theapi/kitchen_timer_stm32/docs/hero2.jpg

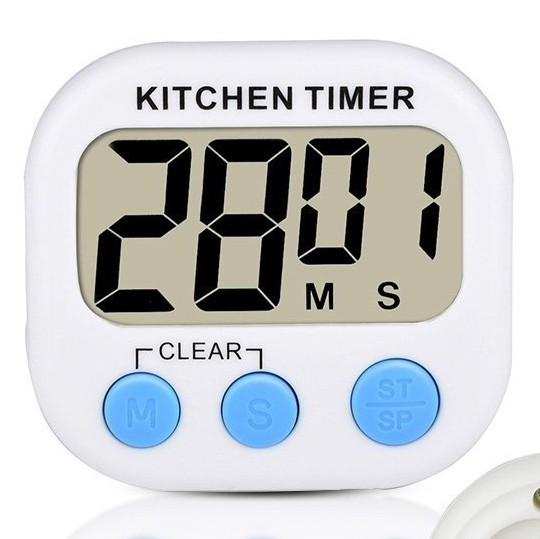
docs/hero2.jpg
