theapi/kitchen_timer_stm32/README.md

# kitchen_timer_stm32
A kitchen timer using the Arm STM32
