theapi/kitchen_timer_stm32/docs/hero.jpg

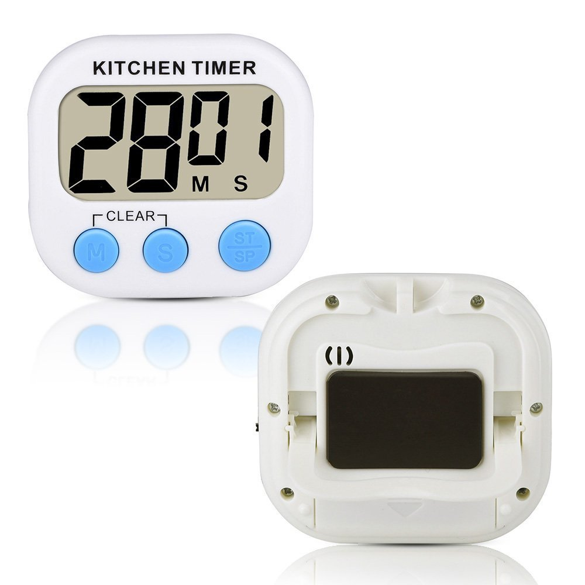
docs/hero.jpg
