theapi/kitchen_timer_stm32/kicad/stm32l053c.pdf

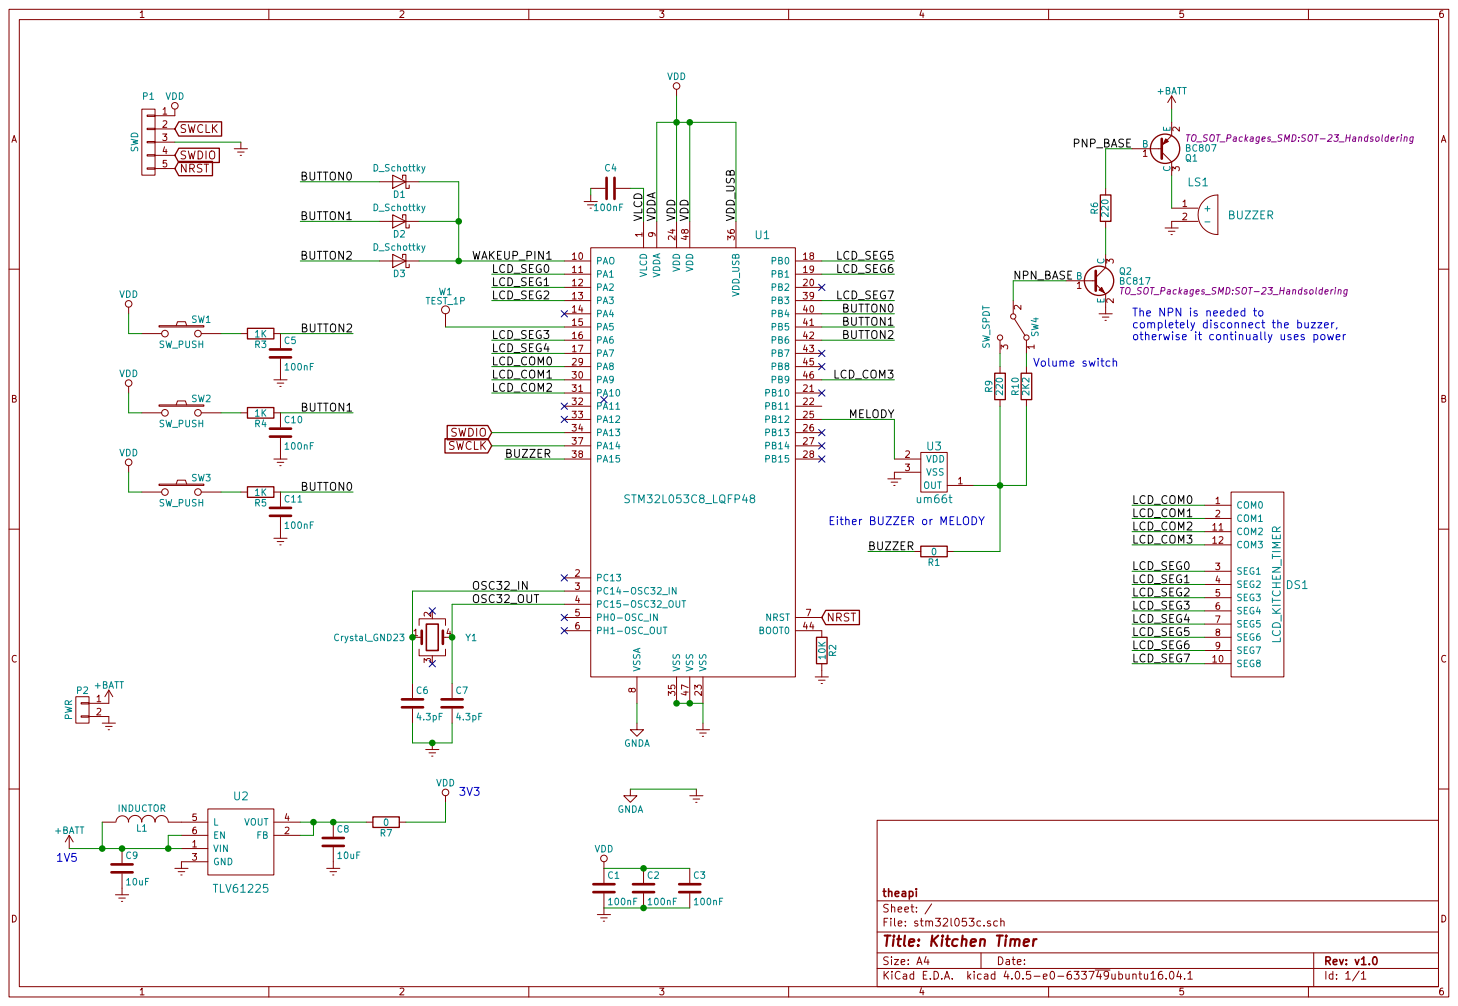
[picture p3: page 1]

LCD_SEG1 | 100nF SWCLK

9 PAO 10 PB2 20 PA9 30 PB4 40 PA1 11 PB10 21 PA10 31 PB5 41 PA2 12 PB11 22 PA11 32 PB6 42 PA3 13 VSS 23 PA12 33 PB7 43 PA4 14 VDD 24 PA13 34 BOOT0 44 PA5 15 PB12 25 VSS 35 PB8 45 PA6 16 PB13 26 VDD_USB 36 PB9 46 PA7 17 PB14 27 PA14 37 VSS 47 PB0 18 PB15 28 PA15 38 VDD 48 PB1 19 PA8 29 PB3 39 U1 STM32L053C8_LQFP48 R2 10K C7

LCD_SEG2

The NPN is needed to completely disconnect the buzzer,

LCD_SEG3 | BUTTON2
LCD_SEG4

otherwise it continually uses power 1

um66t Either BUZZER or MELODY

LCD_SEG1
LCD_SEG3
LCD_SEG5
LCD_SEG6
LCD_SEG7

OSC32_OUT

Id: 1/1 Title: Kitchen Timer File: stm32l053c.sch Sheet: / theapi VDD
