theapi/kitchen_timer_stm32/kicad/stm32l053c.kicad_pcb

## KiCad design kicad/stm32l053c.kicad_pcb (2017-02-12)

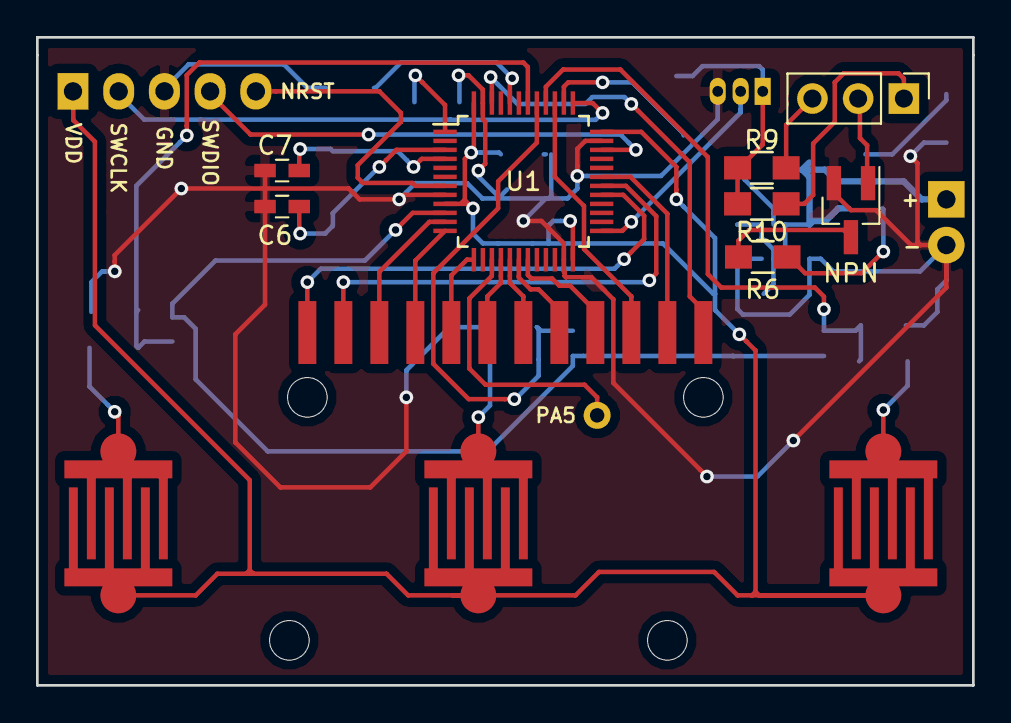
[picture p4: board stm32l053c.kicad_pcb from above]

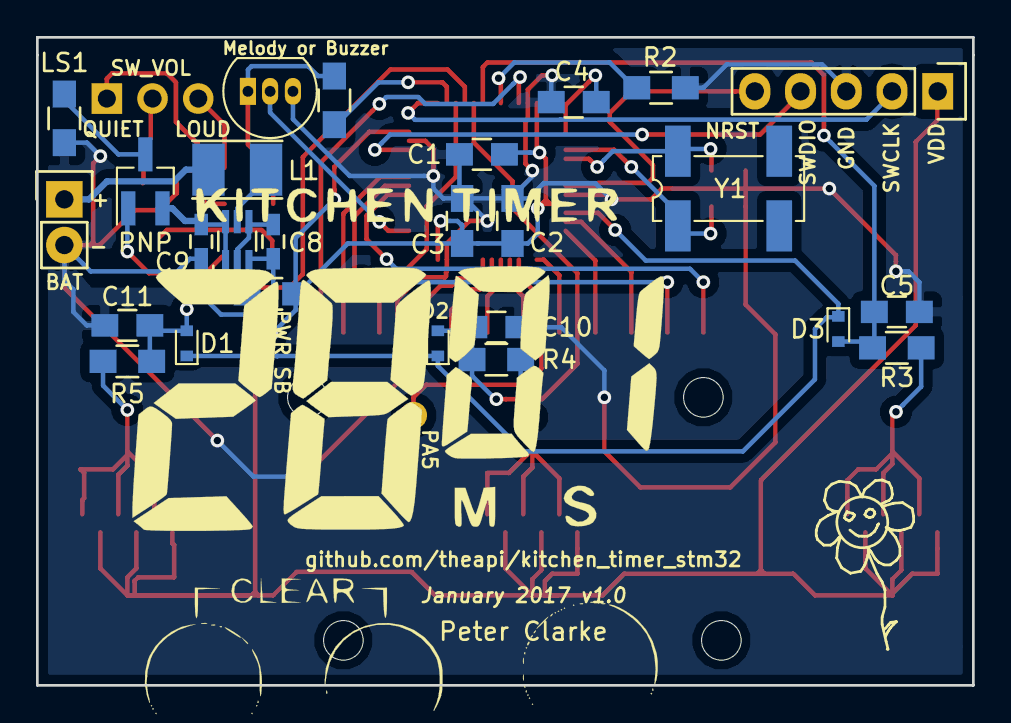
[picture p5: board stm32l053c.kicad_pcb from below]

Board: 2 copper layers, 52.0 x 36.0 mm, 39 parts (26 on the bottom side), 41 nets.

Parts:
BAT: PWR; Pin_Header_Straight_1x02
C1, C2, C3, C4, C5, C10, C11: 100nF; C_0805_HandSoldering
C6, C7: 4.3pF; C_0603_HandSoldering
C8, C9: 10uF; C_0603_HandSoldering
D1, D2, D3: D_Schottky; SOD-523
DS1: LCD_KITCHEN_TIMER; ZEBRA-12
L1: INDUCTOR; Inductor_Taiyo-Yuden_NR-30xx_HandSoldering
LS1: BUZZER; R_0805_HandSoldering
Melody or Buzzer: 0; R_0805_HandSoldering
NPN: BC817; SOT-23_Handsoldering
P1: SWD; Pin_Header_Straight_1x05
PA5: TEST_1P; Measurement_Point_Round-TH_Small
PNP: BC807; SOT-23_Handsoldering
PWR SB: 0; R_0805_HandSoldering
R2: 10K; R_0805_HandSoldering
R3, R4, R5: 1K; R_0805_HandSoldering
R6, R9: 220; R_0805_HandSoldering
R10: 2K2; R_0805_HandSoldering
SW1, SW2, SW3: SW_PUSH; SW_PCB
SW_VOL: SW_SPDT; Pin_Header_Straight_1x03_Pitch2.54mm
U1: STM32L053C8_LQFP48; LQFP-48_7x7mm_Pitch0.5mm
U2: TLV61225; SC-70-6
U3: um66t; UM66T_MELODY
Y1: Crystal_GND23; Crystal_SMD_SeikoEpson_MC306-4pin_8.0x3.2mm_HandSoldering

Connections:
+BATT: BAT.1, C9.1, L1.1, PNP.2, U2.1, U2.6
/BUTTON0: C11.1, D1.2, R5.1, U1.40
/BUTTON1: C10.1, D2.2, R4.1, U1.41
/BUTTON2: C5.1, D3.2, R3.1, U1.42
/BUZZER: Melody or Buzzer.2, U1.38
/LCD_COM0: DS1.1, U1.29
/LCD_COM1: DS1.2, U1.30
/LCD_COM2: DS1.11, U1.31
/LCD_COM3: DS1.12, U1.46
/LCD_SEG0: DS1.3, U1.11
/LCD_SEG1: DS1.4, U1.12
/LCD_SEG2: DS1.5, U1.13
/LCD_SEG3: DS1.6, U1.16
/LCD_SEG4: DS1.7, U1.17
/LCD_SEG5: DS1.8, U1.18
/LCD_SEG6: DS1.9, U1.19
/LCD_SEG7: DS1.10, U1.39
/MELODY: U1.25, U3.2
/NPN_BASE: NPN.1, SW_VOL.2
/OSC32_IN: C6.1, U1.3, Y1.1
/OSC32_OUT: C7.1, U1.4, Y1.4
/PNP_BASE: PNP.1, R6.2
/VLCD: C4.2, U1.1
/WAKEUP_PIN1: D1.1, D2.1, D3.1, U1.10
Earth: BAT.2, C1.2, C2.2, C3.2, C4.1, C5.2, C6.2, C7.2, C8.2, C9.2, C10.2, C11.2, LS1.2, NPN.2, P1.3, R2.2, U1.8, U1.23, U1.35, U1.47, U2.3, U3.3
NRST: P1.5, U1.7
unnamed: C8.1, PWR SB.2, U2.2, U2.4
unnamed: L1.2, U2.5
unnamed: LS1.1, PNP.3
unnamed: NPN.3, R6.1
unnamed: Melody or Buzzer.1, R9.1, R10.1, U3.1
unnamed: R2.1, U1.44
unnamed: R3.2, SW1.2
unnamed: R4.2, SW2.2
unnamed: R5.2, SW3.2
unnamed: R9.2, SW_VOL.3
unnamed: R10.2, SW_VOL.1
unnamed: PA5.1, U1.15
SWCLK: P1.2, U1.37
SWDIO: P1.4, U1.34
VDD: C1.1, C2.1, C3.1, P1.1, PWR SB.1, SW1.1, SW2.1, SW3.1, U1.9, U1.24, U1.36, U1.48
