theapi/kitchen_timer_stm32/SW4STM32/kitchen_timer_stm32/Inc/main.h

/**
 * @file  main.h
 */

#ifndef __MAIN_H
#define __MAIN_H

#define LONG_PRESS 250U                /* Milliseconds */
#define LONG_PRESS_FASTER 100U         /* Milliseconds */
#define LONG_PRESS_FASTER_AFTER 2000U  /* Milliseconds */
#define MAX_IDLE_TIME 120U             /* Seconds */
#define ALARM_DURATION 23000U          /* Milliseconds */
#define ALARM_PULSE 62U                /* Milliseconds */

void Error_Handler(void);

#endif /* __MAIN_H */
