theapi/kitchen_timer_stm32/SW4STM32/kitchen_timer_stm32/Src/screen.c

/*
 * lcd_screen.c
 *
 * The LCD screen as used by the dl1178 chip in the kitchen timer.
 *

Display: HH  MM
Digits:  12  34

8 = A B C D E F G

1 = B C

 Multiplexing:
 1 = B C
     Digit 1 = COM1:SEG7, COM3:SEG7
     Digit 2 = COM1:SEG5, COM3:SEG5
     Digit 3 = COM1:SEG3, COM3:SEG3
     Digit 4 = COM1:SEG1, COM3:SEG1
 2 = A B D E G
     Digit 1 = COM1:SEG8, COM1:SEG7, COM4:SEG7, COM3:SEG8, COM2:SEG7
 ...

 *
 */

#include "screen.h"

// {LCD_SEG_7 | LCD_SEG_8, LCD_SEG_7 | LCD_SEG_8, LCD_SEG_7 | LCD_SEG_8, LCD_SEG_7 | LCD_SEG_8},
/**
 * Digit number, number to display, COM
 */
const uint32_t lcd_digits[4][11][4] = {
    /* Digit 1 */
    {
        /* 0 */
        {
             LCD_SEG_8 | LCD_SEG_7, /* COM1 */
             LCD_SEG_8,             /* COM2 */
             LCD_SEG_8 | LCD_SEG_7, /* COM3 */
             LCD_SEG_7              /* COM4 */
        },
        /* 1 */
        {LCD_SEG_7, 0, LCD_SEG_7, 0},
        /* 2 */
        {LCD_SEG_7 | LCD_SEG_8, LCD_SEG_7, LCD_SEG_8, LCD_SEG_7},
        /* 3 */
        {LCD_SEG_7 | LCD_SEG_8, LCD_SEG_7, LCD_SEG_7, LCD_SEG_7},
        /* 4 */
        {LCD_SEG_7, LCD_SEG_7 | LCD_SEG_8, LCD_SEG_7, 0},
        /* 5 */
        {LCD_SEG_8, LCD_SEG_7 | LCD_SEG_8, LCD_SEG_7, LCD_SEG_7},
        /* 6 */
        {LCD_SEG_8, LCD_SEG_7 | LCD_SEG_8, LCD_SEG_7 | LCD_SEG_8, LCD_SEG_7},
        /* 7 */
        {LCD_SEG_7 | LCD_SEG_8, 0, LCD_SEG_7, 0},
        /* 8 */
        {LCD_SEG_7 | LCD_SEG_8, LCD_SEG_7 | LCD_SEG_8, LCD_SEG_7 | LCD_SEG_8, LCD_SEG_7},
        /* 9 */
        {LCD_SEG_7 | LCD_SEG_8, LCD_SEG_7 | LCD_SEG_8, LCD_SEG_7, LCD_SEG_7},
    },
    /* Digit 2 */
    {
        /* 0 */
        {
             LCD_SEG_6 | LCD_SEG_5, /* COM1 */
             LCD_SEG_6,             /* COM2 */
             LCD_SEG_6 | LCD_SEG_5, /* COM3 */
             LCD_SEG_5              /* COM4 */
        },
        /* 1 */
        {LCD_SEG_5, 0, LCD_SEG_5, 0},
        /* 2 */
        {LCD_SEG_5 | LCD_SEG_6, LCD_SEG_5, LCD_SEG_6, LCD_SEG_5},
        /* 3 */
        {LCD_SEG_5 | LCD_SEG_6, LCD_SEG_5, LCD_SEG_5, LCD_SEG_5},
        /* 4 */
        {LCD_SEG_5, LCD_SEG_5 | LCD_SEG_6, LCD_SEG_5, 0},
        /* 5 */
        {LCD_SEG_6, LCD_SEG_5 | LCD_SEG_6, LCD_SEG_5, LCD_SEG_5},
        /* 6 */
        {LCD_SEG_6, LCD_SEG_5 | LCD_SEG_6, LCD_SEG_5 | LCD_SEG_6, LCD_SEG_5},
        /* 7 */
        {LCD_SEG_5 | LCD_SEG_6, 0, LCD_SEG_5, 0},
        /* 8 */
        {LCD_SEG_5 | LCD_SEG_6, LCD_SEG_5 | LCD_SEG_6, LCD_SEG_5 | LCD_SEG_6, LCD_SEG_5},
        /* 9 */
        {LCD_SEG_5 | LCD_SEG_6, LCD_SEG_5 | LCD_SEG_6, LCD_SEG_5, LCD_SEG_5},
    },
    /* Digit 3 */
    {
        /* 0 */
        {LCD_SEG_4 | LCD_SEG_3, LCD_SEG_4, LCD_SEG_4 | LCD_SEG_3, LCD_SEG_3},
        /* 1 */
        {LCD_SEG_3, 0, LCD_SEG_3, 0},
        /* 2 */
        {LCD_SEG_3 | LCD_SEG_4,LCD_SEG_3, LCD_SEG_4, LCD_SEG_3},
        /* 3 */
        {LCD_SEG_3 | LCD_SEG_4, LCD_SEG_3, LCD_SEG_3, LCD_SEG_3},
        /* 4 */
        {LCD_SEG_3, LCD_SEG_3 | LCD_SEG_4, LCD_SEG_3, 0},
        /* 5 */
        {LCD_SEG_4, LCD_SEG_3 | LCD_SEG_4, LCD_SEG_3, LCD_SEG_3},
        /* 6 */
        {LCD_SEG_4, LCD_SEG_3 | LCD_SEG_4, LCD_SEG_3 | LCD_SEG_4, LCD_SEG_3},
        /* 7 */
        {LCD_SEG_3 | LCD_SEG_4, 0, LCD_SEG_3, 0},
        /* 8 */
        {LCD_SEG_3 | LCD_SEG_4, LCD_SEG_3 | LCD_SEG_4, LCD_SEG_3 | LCD_SEG_4, LCD_SEG_3},
        /* 9 */
        {LCD_SEG_3 | LCD_SEG_4, LCD_SEG_3 | LCD_SEG_4, LCD_SEG_3, LCD_SEG_3},
    },
    /* Digit 4 */
    {
        /* 0 */
        {LCD_SEG_2 | LCD_SEG_1, LCD_SEG_2, LCD_SEG_2 | LCD_SEG_1, LCD_SEG_1},
        /* 1 */
        {LCD_SEG_1, 0, LCD_SEG_1, 0},
        /* 2 */
        {LCD_SEG_1 | LCD_SEG_2, LCD_SEG_1, LCD_SEG_2, LCD_SEG_1},
        /* 3 */
        {LCD_SEG_1 | LCD_SEG_2, LCD_SEG_1, LCD_SEG_1, LCD_SEG_1},
        /* 4 */
        {LCD_SEG_1, LCD_SEG_1 | LCD_SEG_2, LCD_SEG_1, 0},
        /* 5 */
        {LCD_SEG_2, LCD_SEG_1 | LCD_SEG_2, LCD_SEG_1, LCD_SEG_1},
        /* 6 */
        {LCD_SEG_2, LCD_SEG_1 | LCD_SEG_2, LCD_SEG_1 | LCD_SEG_2, LCD_SEG_1},
        /* 7 */
        {LCD_SEG_1 | LCD_SEG_2, 0, LCD_SEG_1, 0},
        /* 8 */
        {LCD_SEG_1 | LCD_SEG_2, LCD_SEG_1 | LCD_SEG_2, LCD_SEG_1 | LCD_SEG_2, LCD_SEG_1},
        /* 9 */
        {LCD_SEG_1 | LCD_SEG_2, LCD_SEG_1 | LCD_SEG_2, LCD_SEG_1, LCD_SEG_1},
    },
};

/**
 * Do an update of the screen content if needed.
 */
void Screen_Process(LCD_HandleTypeDef *hlcd, KT_TypeDef *kt) {
    if (kt->update == 1) {
        kt->update = 0;
        /* Update the screen */
        Screen_Update(hlcd, kt->minutes, kt->seconds, kt->ampm);
    }
}

/**
 * Show the minutes, seconds & M/S on the display.
 */
void Screen_Update(LCD_HandleTypeDef *hlcd, uint8_t minutes, uint8_t seconds, uint8_t ampm) {

    uint8_t minutes_tens = 0;
    uint8_t minutes_singles = minutes % 10;
    uint8_t seconds_tens = 0;
    uint8_t seconds_singles = seconds % 10;

    if (minutes > 9) {
        minutes_tens = (minutes / 10) % 10;
    }
    if (seconds > 9) {
        seconds_tens = (seconds / 10) % 10;
    }

    LCD->RAM[LCD_RAM_REGISTER0] = lcd_digits[0][minutes_tens][0]
            | lcd_digits[1][minutes_singles][0] | lcd_digits[2][seconds_tens][0]
            | lcd_digits[3][seconds_singles][0];

    LCD->RAM[LCD_RAM_REGISTER2] = lcd_digits[0][minutes_tens][1]
            | lcd_digits[1][minutes_singles][1] | lcd_digits[2][seconds_tens][1]
            | lcd_digits[3][seconds_singles][1];

    /* Registers 4 & 6 are swapped because they're swapped on the pcb (oops) */
    LCD->RAM[LCD_RAM_REGISTER6] = lcd_digits[0][minutes_tens][2]
            | lcd_digits[1][minutes_singles][2] | lcd_digits[2][seconds_tens][2]
            | lcd_digits[3][seconds_singles][2];

    LCD->RAM[LCD_RAM_REGISTER4] = lcd_digits[0][minutes_tens][3]
            | lcd_digits[1][minutes_singles][3] | lcd_digits[2][seconds_tens][3]
            | lcd_digits[3][seconds_singles][3];

    if (ampm == 1) {
        LCD->RAM[LCD_RAM_REGISTER4] |= LCD_SEG_4;
    }

    HAL_LCD_UpdateDisplayRequest(hlcd);
}

/**
 * Start blinking the display.
 */
void Screen_BlinkStart(LCD_HandleTypeDef *hlcd) {
    LCD->FCR |= LCD_BLINKMODE_ALLSEG_ALLCOM | LCD_BLINKFREQUENCY_DIV512;
}

/**
 * Stop blinking the display.
 */
void Screen_BlinkStop(LCD_HandleTypeDef *hlcd) {
    LCD->FCR &= ~(LCD_BLINKMODE_ALLSEG_ALLCOM);
}

/**
 * Clear the display.
 */
void Screen_Clear(LCD_HandleTypeDef *hlcd) {
    LCD->RAM[LCD_RAM_REGISTER0] = 0;
    LCD->RAM[LCD_RAM_REGISTER2] = 0;
    LCD->RAM[LCD_RAM_REGISTER4] = 0;
    LCD->RAM[LCD_RAM_REGISTER6] = 0;
    HAL_LCD_UpdateDisplayRequest(hlcd);
}
