theapi/kitchen_timer_stm32/SW4STM32/kitchen_timer_stm32/Src/gpio.c

/**
 * @file gpio.c
 * Description: This file provides code for the configuration
 */

#include "gpio.h"

/**
 * Configure pins as
 * Analog
 * Input
 * Output
 * EVENT_OUT
 * EXTI
 * Free pins are configured automatically as Analog
 */
void MX_GPIO_Init(void) {

    GPIO_InitTypeDef GPIO_InitStruct;

    /* GPIO Ports Clock Enable */
    __HAL_RCC_GPIOC_CLK_ENABLE()
    ;
    __HAL_RCC_GPIOH_CLK_ENABLE()
    ;
    __HAL_RCC_GPIOA_CLK_ENABLE()
    ;
    __HAL_RCC_GPIOB_CLK_ENABLE()
    ;

    /*Configure GPIO pins : PH0 PH1 */
    GPIO_InitStruct.Pin = GPIO_PIN_0 | GPIO_PIN_1;
    GPIO_InitStruct.Mode = GPIO_MODE_ANALOG;
    GPIO_InitStruct.Pull = GPIO_NOPULL;
    HAL_GPIO_Init(GPIOH, &GPIO_InitStruct);

    /*Configure GPIO pins : PA4 PA11 PA12 PA15 */
    GPIO_InitStruct.Pin = GPIO_PIN_4|GPIO_PIN_11|GPIO_PIN_12|GPIO_PIN_15;
    GPIO_InitStruct.Mode = GPIO_MODE_ANALOG;
    GPIO_InitStruct.Pull = GPIO_NOPULL;
    HAL_GPIO_Init(GPIOA, &GPIO_InitStruct);

    /*Configure GPIO pin : PA5 */
    GPIO_InitStruct.Pin = GPIO_PIN_5;
    GPIO_InitStruct.Mode = GPIO_MODE_OUTPUT_PP;
    GPIO_InitStruct.Pull = GPIO_NOPULL;
    GPIO_InitStruct.Speed = GPIO_SPEED_FREQ_LOW;
    HAL_GPIO_Init(GPIOA, &GPIO_InitStruct);

    /*Configure GPIO pins : PB2 PB10 PB11 PB15
     PB13 PB14 PB7 PB8 */
    GPIO_InitStruct.Pin = GPIO_PIN_2 | GPIO_PIN_10 | GPIO_PIN_11 | GPIO_PIN_12 | GPIO_PIN_15
            | GPIO_PIN_13 | GPIO_PIN_14 | GPIO_PIN_7 | GPIO_PIN_8;
    GPIO_InitStruct.Mode = GPIO_MODE_ANALOG;
    GPIO_InitStruct.Pull = GPIO_NOPULL;
    HAL_GPIO_Init(GPIOB, &GPIO_InitStruct);

    /*Configure GPIO pin : PB12 */
//    GPIO_InitStruct.Pin = GPIO_PIN_12;
//    GPIO_InitStruct.Mode = GPIO_MODE_OUTPUT_PP;
//    GPIO_InitStruct.Pull = GPIO_PULLDOWN;
//    GPIO_InitStruct.Speed = GPIO_SPEED_FREQ_LOW;
//    HAL_GPIO_Init(GPIOB, &GPIO_InitStruct);

    /*Configure GPIO pins : PB4 PB5 PB6 */
    GPIO_InitStruct.Pin = GPIO_PIN_4 | GPIO_PIN_5 | GPIO_PIN_6;
    GPIO_InitStruct.Mode = GPIO_MODE_IT_RISING_FALLING;
    GPIO_InitStruct.Pull = GPIO_PULLDOWN;
    HAL_GPIO_Init(GPIOB, &GPIO_InitStruct);

    /*Configure GPIO pin Output Level */
    HAL_GPIO_WritePin(GPIOA, GPIO_PIN_5, GPIO_PIN_RESET);

    /*Configure GPIO pin Output Level */
    HAL_GPIO_WritePin(GPIOB, GPIO_PIN_12, GPIO_PIN_RESET);

    /* EXTI interrupt init*/
    HAL_NVIC_SetPriority(EXTI4_15_IRQn, 0, 0);
    HAL_NVIC_EnableIRQ(EXTI4_15_IRQn);

}
