theapi/kitchen_timer_stm32/SW4STM32/kitchen_timer_stm32/Inc/gpio.h

/**
 * @file gpio.h
 */

#ifndef __gpio_H
#define __gpio_H
#ifdef __cplusplus
extern "C" {
#endif

#include "stm32l0xx_hal.h"
#include "main.h"

void MX_GPIO_Init(void);

#ifdef __cplusplus
}
#endif
#endif /* __gpio_H */
