theapi/kitchen_timer_stm32/SW4STM32/kitchen_timer_stm32/Inc/rtc.h

/**
 * @file RTC.h
 */

#ifndef __rtc_H
#define __rtc_H
#ifdef __cplusplus
extern "C" {
#endif

#include "stm32l0xx_hal.h"
#include "main.h"

extern RTC_HandleTypeDef hrtc;
extern void Error_Handler(void);

void MX_RTC_Init(void);

#ifdef __cplusplus
}
#endif
#endif /*__ rtc_H */
