theapi/kitchen_timer_stm32/(commit log)

2016-12-11 Start of schematic
    [stm32l053c.kicad_pcb, stm32l053c.sch]
2016-12-12 Updated footprint
    [stm32l053c.sch]
2016-12-12 LCD footprint
    [stm32l053c.sch]
2016-12-12 LCD connections
    [stm32l053c.sch]
2016-12-12 Power supply
    [stm32l053c.sch]
2016-12-14 Button debounce
    [stm32l053c.sch]
2016-12-15 Some footprints
    [stm32l053c.sch]
2016-12-17 Mosfet to drive the buzzer
    [stm32l053c.sch]
2016-12-19 Footprints for buttons & zebra
    [stm32l053c.sch]
2016-12-19 Initial layout
    [stm32l053c.sch]
2016-12-19 Changing the pcb button
    [stm32l053c.kicad_pcb]
2016-12-19 Fixed the pcb buttons
    [stm32l053c.kicad_pcb]
2016-12-19 Enclosure sizes
    [stm32l053c.kicad_pcb]
2016-12-19 Layout to fit the enclosure
    [stm32l053c.kicad_pcb, stm32l053c.sch]
2016-12-21 Initial code import
    [kitchen_timer_stm32.cfg]
2016-12-22 Handle buttons in a state machine
2016-12-23 Change the systick interrupt to not wake up every millisecond
2016-12-23 Disable the systick interrupt to not wake up every millisecond
2017-01-01 62 ms pulses of 2048Hz for the buzzer alarm
    [stm32l053c.sch]
2017-01-01 alarm triggered pin
2017-01-01 Schematic pdf
2017-01-01 Stop the alarm with the ST/SP button
2017-01-02 Buzzer or Melody
    [stm32l053c.sch]
2017-01-02 NCP1400A as a possible boost converter
    [stm32l053c.sch]
2017-01-02 boost regulator docs
2017-01-02 Updated schematic pdf
2017-01-02 Layout (WIP)
    [stm32l053c.kicad_pcb]
2017-01-02 Moved the melody pin
    [stm32l053c.sch]
2017-01-02 Fixed the melody output
    [stm32l053c.kicad_pcb, stm32l053c.sch]
2017-01-02 Stop noise on the buzzer
    [stm32l053c.sch]
2017-01-02 Pull down on the buzzer transistor
    [stm32l053c.sch]
2017-01-03 Buzzer transistor to be decided
    [stm32l053c.sch]
2017-01-03 BC817 transistor
    [stm32l053c.sch]
2017-01-03 PNP & more layout
    [stm32l053c.kicad_pcb, stm32l053c.sch]
2017-01-03 Re-wired the zebra strip
    [stm32l053c.kicad_pcb]
2017-01-10 Moved the kitchen timer state into the kt struct
2017-01-10 The NPN is needed to completely disconnect the buzzer, otherwise it continually uses power
    [stm32l053c.kicad_pcb, stm32l053c.sch]
2017-01-10 Moved button handling to separate files
2017-01-11 check for & handle a button interrupt before sleeping
2017-01-12 4.3pF caps on the crystal as in the Nucleo board
    [stm32l053c.sch]
2017-01-15 Speed up the setting is the button is held longer
2017-01-15 Crystal & melody footprints
    [stm32l053c.kicad_pcb, stm32l053c.sch]
2017-01-16 Bottom initial routing
    [stm32l053c.kicad_pcb]
2017-01-17 Moved the MCU to the top of the board
    [stm32l053c.kicad_pcb, stm32l053c.sch]
2017-01-17 Init buttons & output button pressed to PA5
2017-01-17 Moved the buzzer pin to a more convenient location
    [stm32l053c.kicad_pcb, stm32l053c.sch]
2017-01-18 Power supply connections
    [stm32l053c.kicad_pcb]
2017-01-18 All connected & DRC pass
    [stm32l053c.kicad_pcb, stm32l053c.sch]
2017-01-18 Image of the readout on the pcb
    [stm32l053c.kicad_pcb]
2017-01-19 Boost converted on separate ground
    [stm32l053c.kicad_pcb]
2017-01-19 Hand solder friendly footprint for the boost regulator
    [stm32l053c.kicad_pcb]
2017-01-23 Cropped hero silkscreen
    [stm32l053c.kicad_pcb]
2017-01-23 Routing tweeks
    [stm32l053c.kicad_pcb]
2017-02-12 Corrected the labels for the button R/C
    [stm32l053c.kicad_pcb]
2017-02-13 Swap LCD ram registers
    [screen.c]
2017-03-18 Flashed both timers
